electronoora/eurorack/README.md

# eurorack
This is a repository for Noora's eurorack hardware projects.

* [Launch Vehicle](launch-vehicle/) - a 6hp utility module for switching and
  muting gate/trigger signals.
