electronoora/eurorack/launch-vehicle/Hardware/Front panel/README.md

Front panel is designed to be manufactured using the Oshpark After Dark fabrication process which uses a clear solder mask.
