electronoora/eurorack/launch-vehicle/Hardware/Switch spacer/pcb_spacers.jpeg

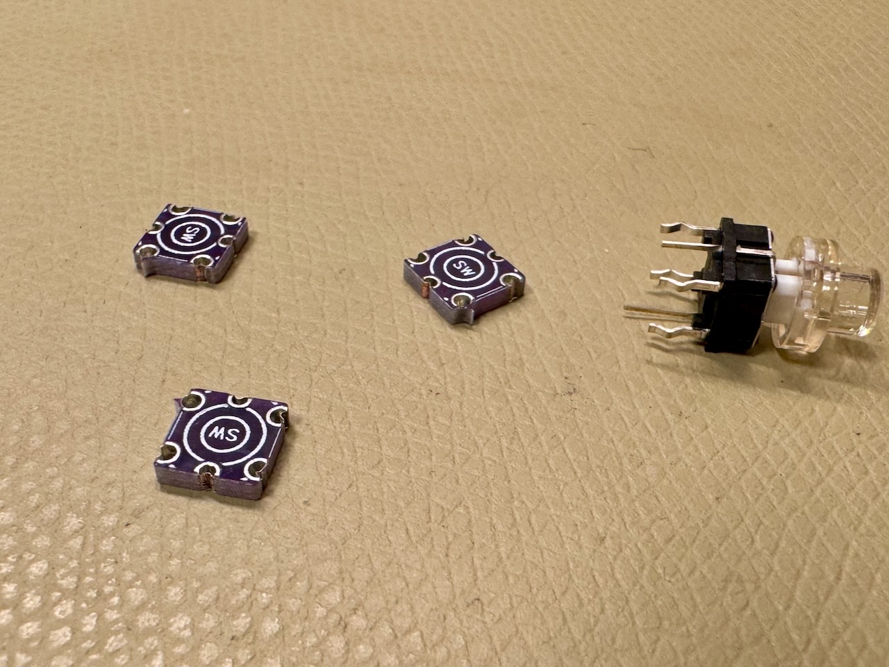
launch-vehicle/Hardware/Switch spacer/pcb_spacers.jpeg
