electronoora/eurorack/launch-vehicle/Hardware/Switch spacer/spacer.png

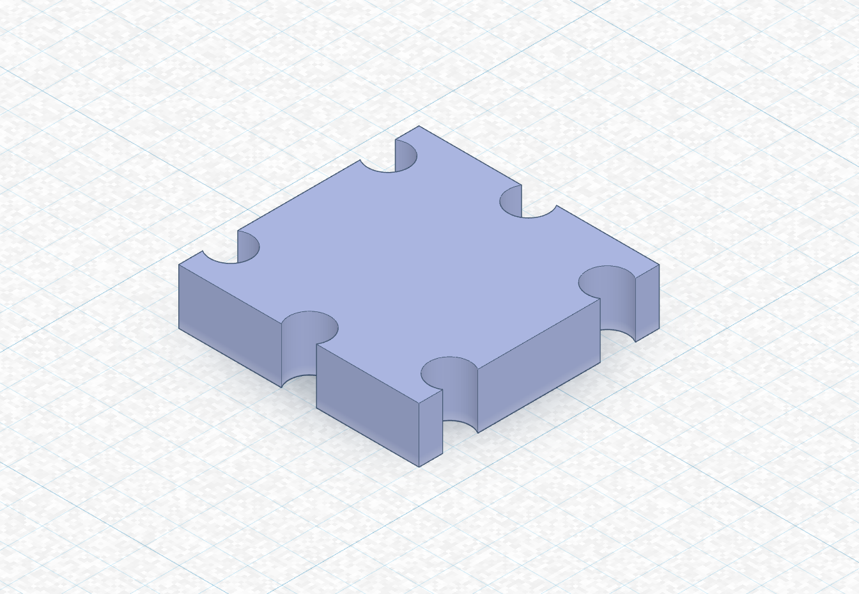
launch-vehicle/Hardware/Switch spacer/spacer.png
