electronoora/eurorack/launch-vehicle/Hardware/Switch spacer/spacers_fitted.jpeg

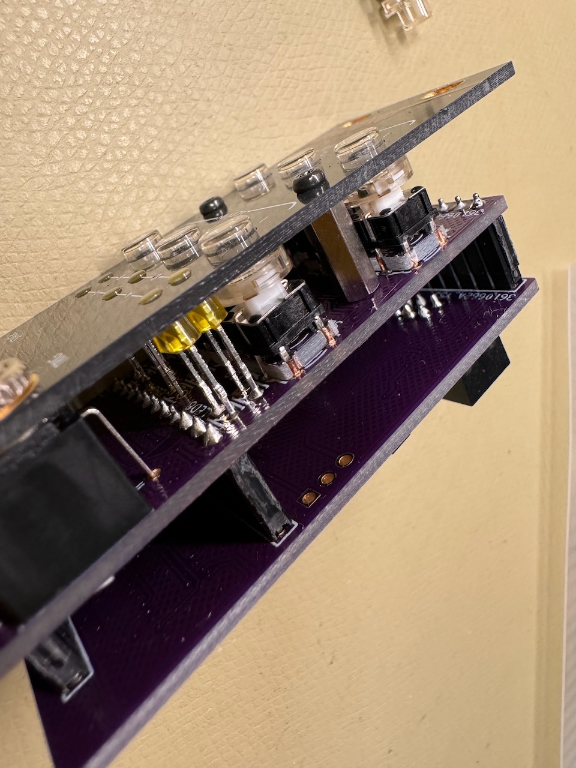
launch-vehicle/Hardware/Switch spacer/spacers_fitted.jpeg
