electronoora/eurorack/launch-vehicle/Images/launch_vehicle.png

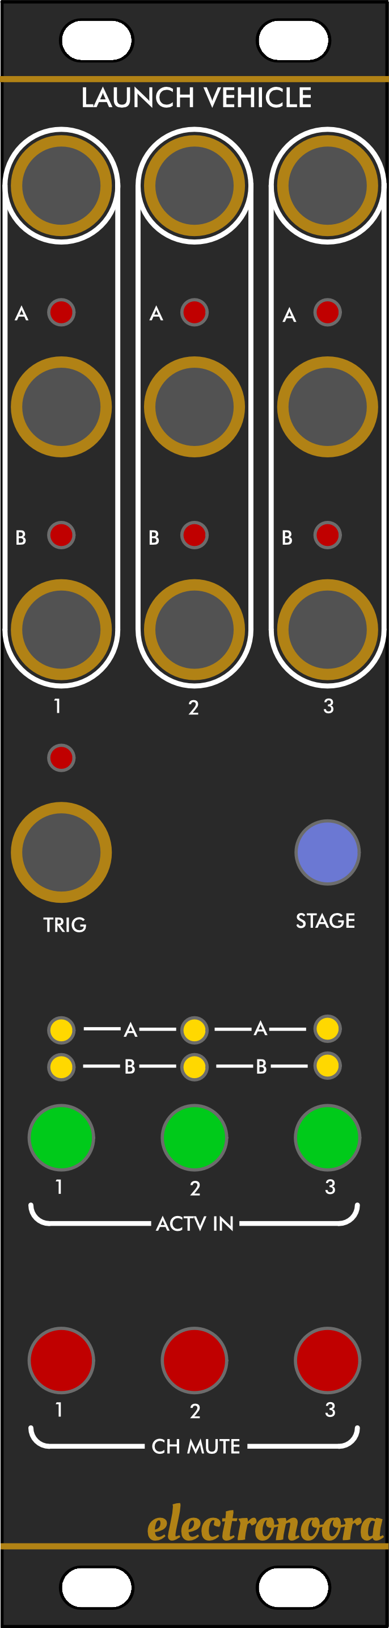
launch-vehicle/Images/launch_vehicle.png
