electronoora/eurorack/launch-vehicle/Images/launch_vehicle_buttons.png

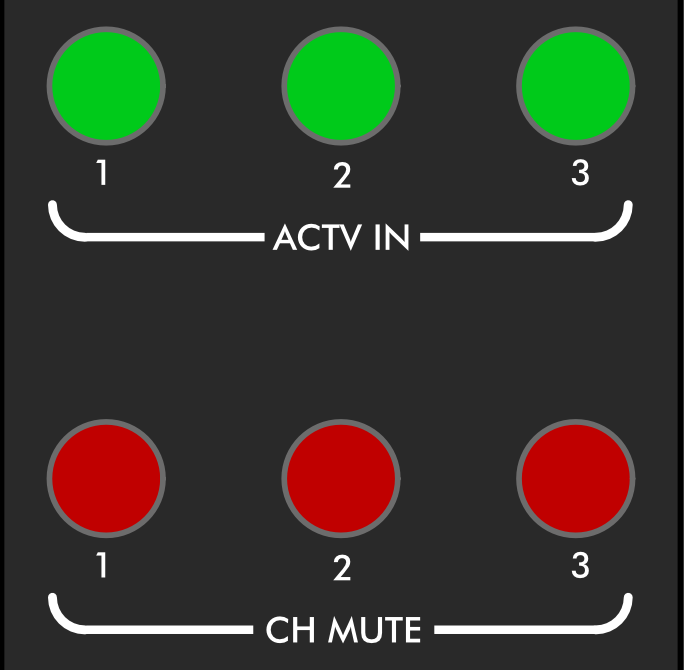
launch-vehicle/Images/launch_vehicle_buttons.png
