electronoora/eurorack/launch-vehicle/Images/launch_vehicle_channel.png

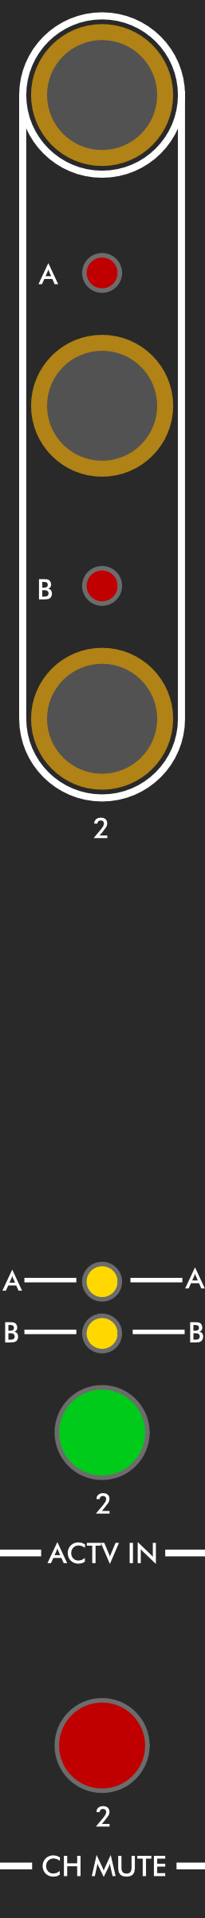
launch-vehicle/Images/launch_vehicle_channel.png
