electronoora/eurorack/launch-vehicle/Images/launch_vehicle_staging.png

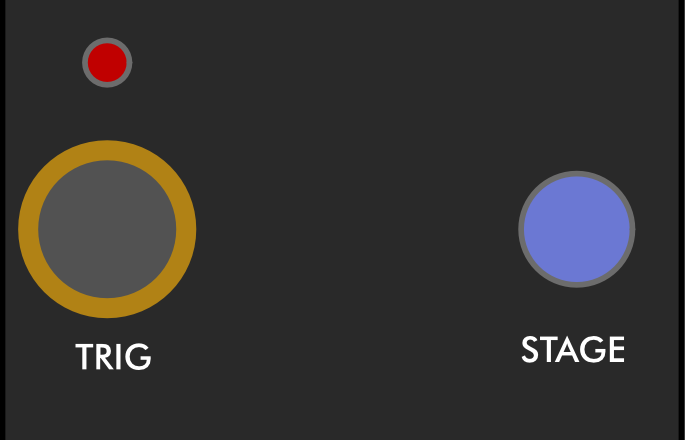
launch-vehicle/Images/launch_vehicle_staging.png
