electronoora/eurorack/launch-vehicle/Images/panel_and_pcbs.jpeg

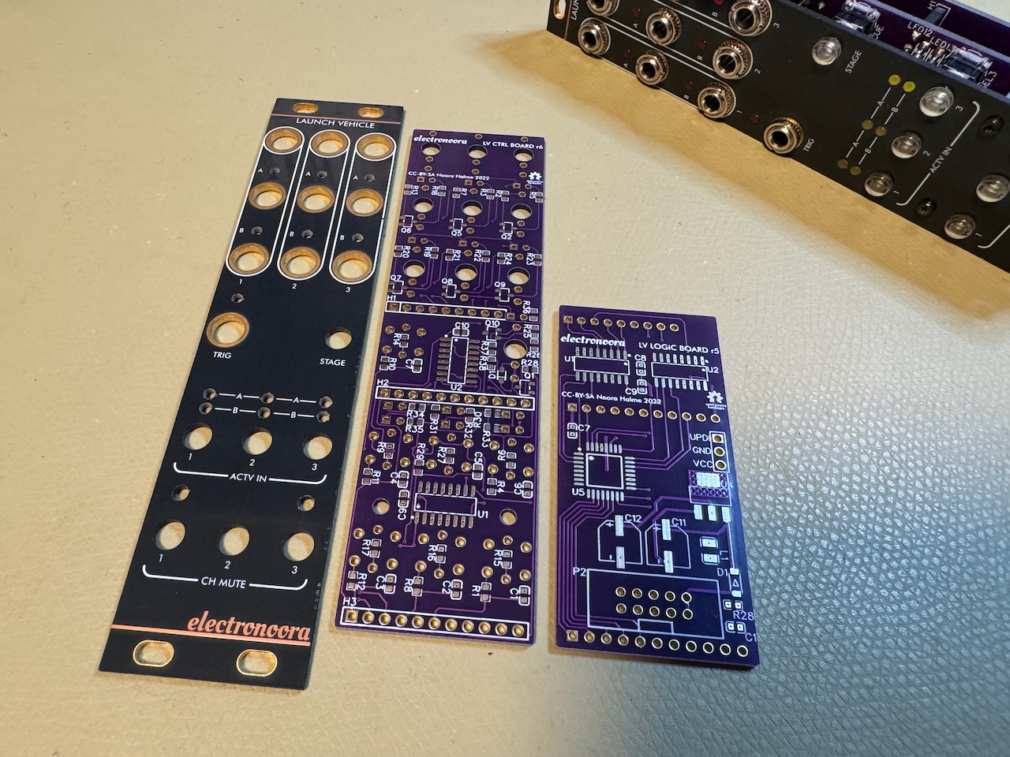
launch-vehicle/Images/panel_and_pcbs.jpeg
