electronoora/eurorack/launch-vehicle/Images/pcb_stack.jpeg

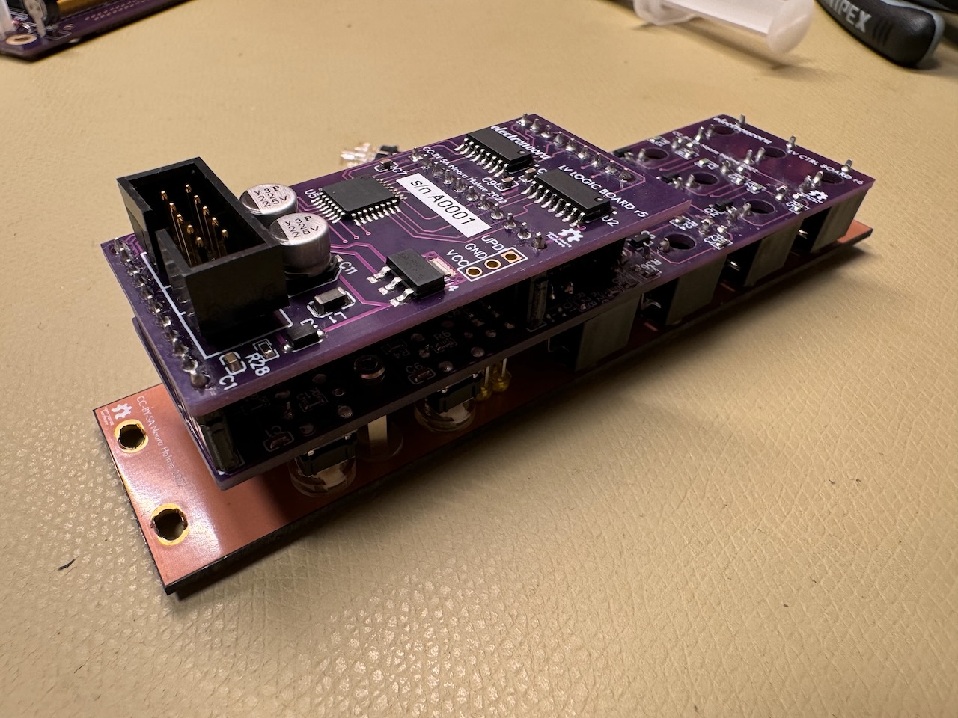
launch-vehicle/Images/pcb_stack.jpeg
