electronoora/eurorack/launch-vehicle/Images/prototype_2.jpeg

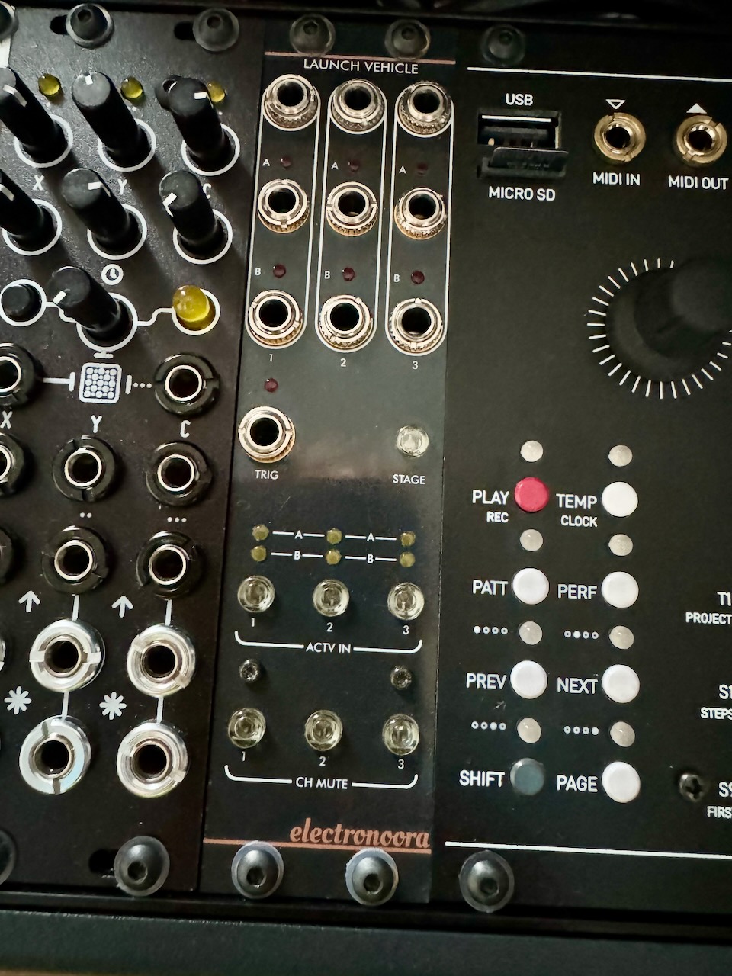
launch-vehicle/Images/prototype_2.jpeg
