electronoora/eurorack/launch-vehicle/Hardware/BOM.md

Bill of materials for Launch Vehicle

# Logic board

| Quantity | Reference | Value | Mfr p/n | Mouser p/n | Notes |
| --- | --- | --- | --- | --- | --- |
| 2 | U1, U2 | | DG4053EEY-T1-GE3 | ... | ... |
| 1 | U4 | | LM1117S-5.0 | ... | ... |
| 1 | U5 | | ATMEGA808-AU | ... | ... |
| 1 | D1 | | SM5817PL-TP | ... | ... |
| 4 | C1, C7, C8, C9 | 100nF |GCM188R71E104KA57D | ... | ... |
| 2 | C11, C12 | 22uF | EEE1EA220SP | ... | ... |
| 1 | R28 | 10K | RC0603DR-0710KL | ... | ... |
| 1 | L1 | 100µH | LB3218T100K | ... | ... |
| 2 | H1, H2 | |  | 855-M20-9771146 | Pin header, 11 pin |
| 1 | H3 | |  | 855-M20-9990946 | Pin header, 9 pin |
| 1 | UPDI | |  | ... | Pin header, 3 pin |
| 1 | P2 | |  | ... | IDC box header, 2x5 pin |

# Control board

| Quantity | Reference | Value | Mfr p/n | Mouser p/n | Notes |
| --- | --- | --- | --- | --- | --- |
| 2 | U1, U2 | | TPIC6C595DR | ... | ... |
| 7 | Q2, Q5, Q6, Q7, Q8, Q9, Q10 | | MMBT3904LT1G | ... | ... |
| 9 | C1, C2, C3, C4, C5, C6, C7, C9, C10 | 100nF | GCM188R71E104KA57D | ... | ... |
| 7 | R2, R7, R13, R20, R21, R24, R25 | 100K | RC0603JR-07100KL |
| 7 | R4, R10, R11, R29, R1, R8, R12 | 510R | RC0603JR-07510RL |
| 16 | R30, R31, R32, R33, R34, R35, R36, R3, R5, R18, R19, R22, R23 | 300R | RC0603FR-07300RL |
| 4 | R14, R15, R16, R17, R6, R9, R27 | 2K2 | 
| 1 | R26 | 33K | RC0603JR-0733KL |
| 7 | LED1, LED2, LED3, LED4, LED5, LED6, LED7 | | .. | .. | Red, 2mm tapered |
| 6 | LED8, LED9, LED10, LED11, LED12, LED13 | | .. | .. | Yellow, 2mm tapered |
| 3 | MUTE1,MUTE2,MUTE3 | | TL1265RQSCLR | .. | Red |
| 3 | SEL1,SEL2,SEL3 | |TL1265GQSCLR | .. | Green |
| 1 | CUE | | TL1265BQSCLR | .. | Blue
| 1 | H1 | |  | .. | Socket header, 9 pin |
| 2 | H2, H3 | | | .. | Socket header, 11 pin | 
| 10 | CLOCK, IN_1A, IN_1B, IN_2A, IN_2B, IN_3A, IN_3B, OUT1, OUT2, OUT3 | | PJ398SM | - | Thonkiconn |	
| 6 | - | - | - | - | 1.6mm spacer under the tactile buttons |

# Common hardware

| Quantity | Description | 
| --- | --- |
| 2 | M2 washer |
| 2 | M2 10mm standoff |
| 4 | M2x6mm screw |
