electronoora/eurorack/launch-vehicle/Hardware/Switch spacer/TL1265 switch 1.6mm spacer.stl

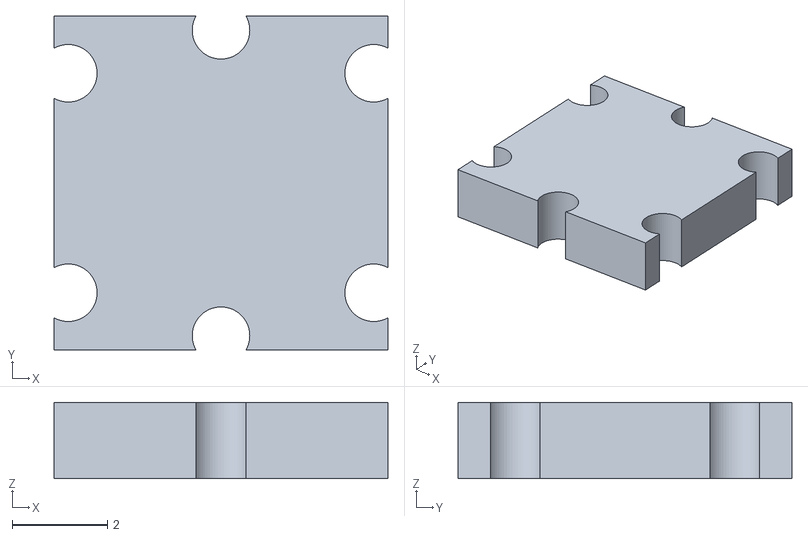
[picture p12: CAD file, 2024-09-16]
launch-vehicle/Hardware/Switch spacer/TL1265 switch 1.6mm spacer.stl
7.00 x 7.00 x 1.60
