electronoora/eurorack/launch-vehicle/Hardware/Logic board/Schematic.pdf

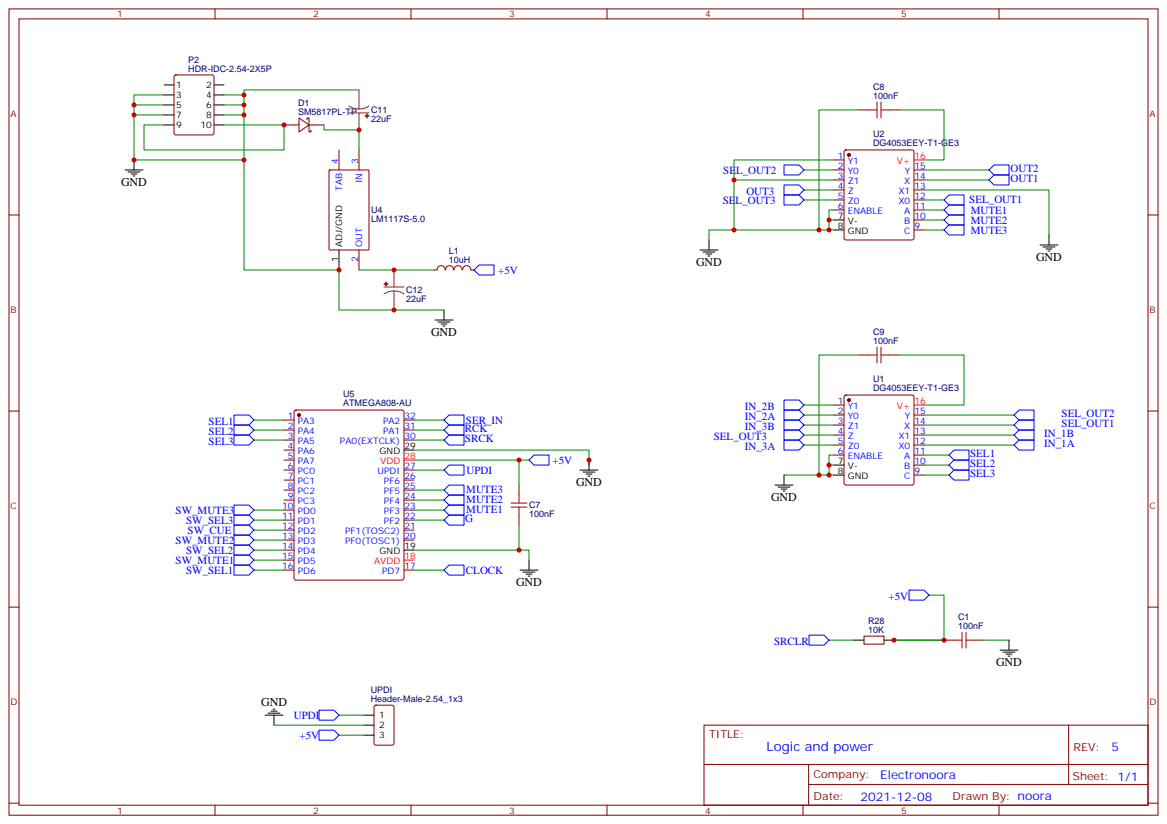
[picture p23: page 1]

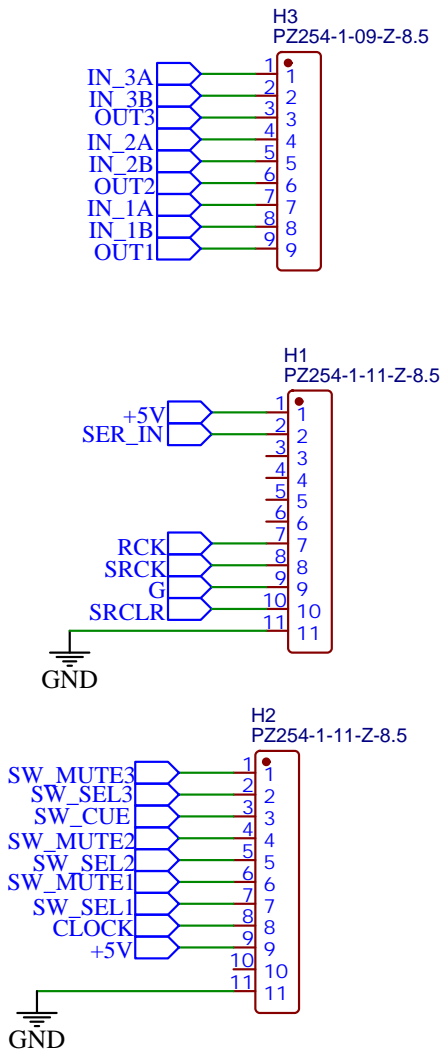
[picture p24: page 2]
