electronoora/eurorack/(commit log)

2024-09-16 Initial commit to public GitHub repository.
    [TL1265 switch 1.6mm spacer.stl]
2024-09-16 Update README.md with prototype image.
2024-09-16 Update BOM.md formatting
